kripanshukumar/40hz_brain_wave/Images/IMG_20211009_141126.jpg

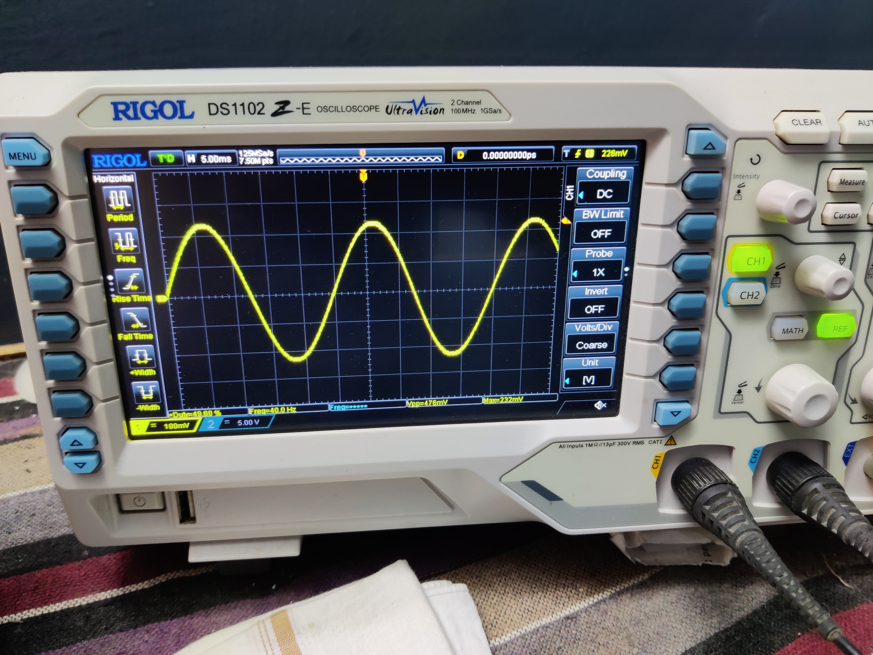
Images/IMG_20211009_141126.jpg
