kripanshukumar/40hz_brain_wave/Images/16253927686848596920687307934046.jpg

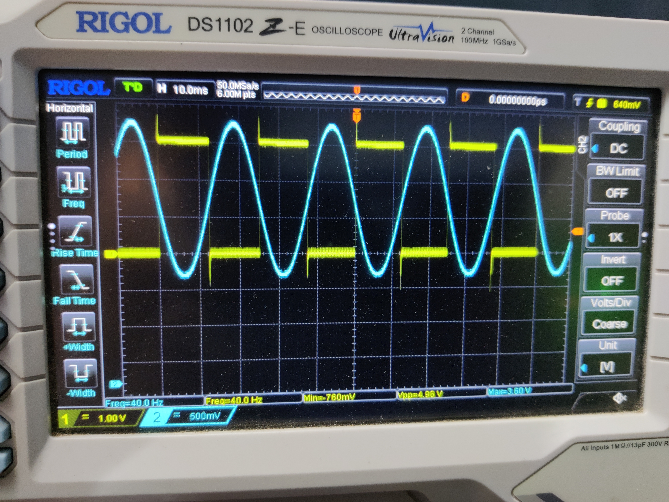
Images/16253927686848596920687307934046.jpg
