kripanshukumar/40hz_brain_wave/Images/IMG_20211008_235200.jpg

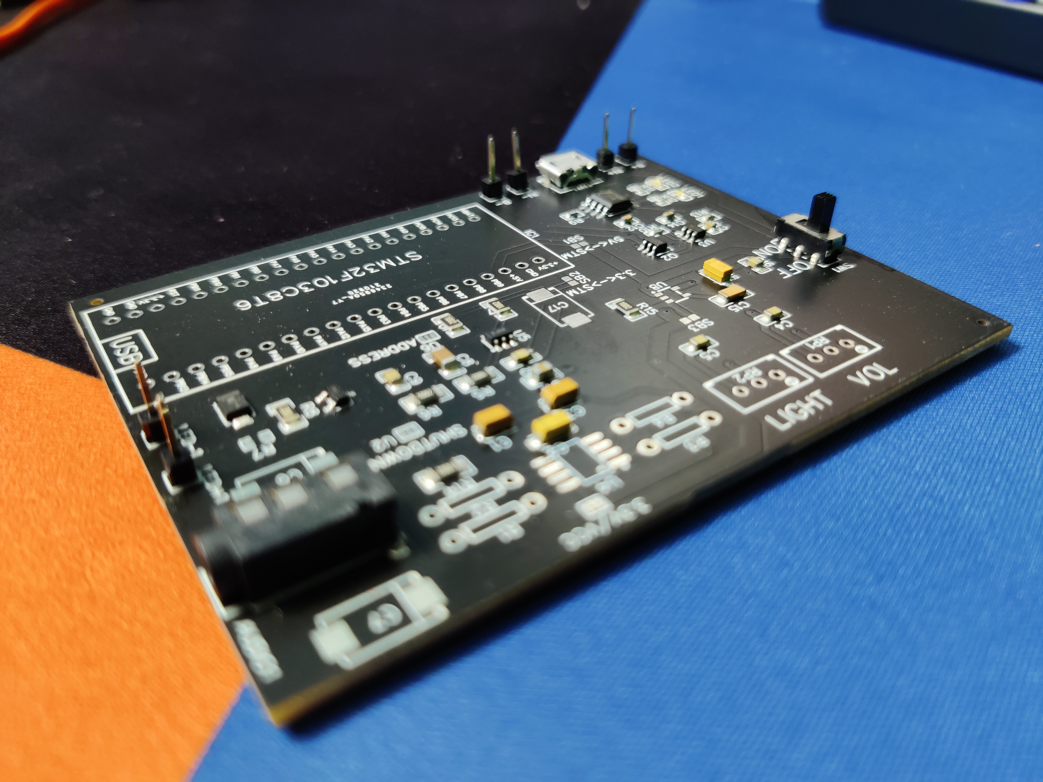
Images/IMG_20211008_235200.jpg
