kripanshukumar/40hz_brain_wave/Images/IMG_20211009_141535__01.jpg

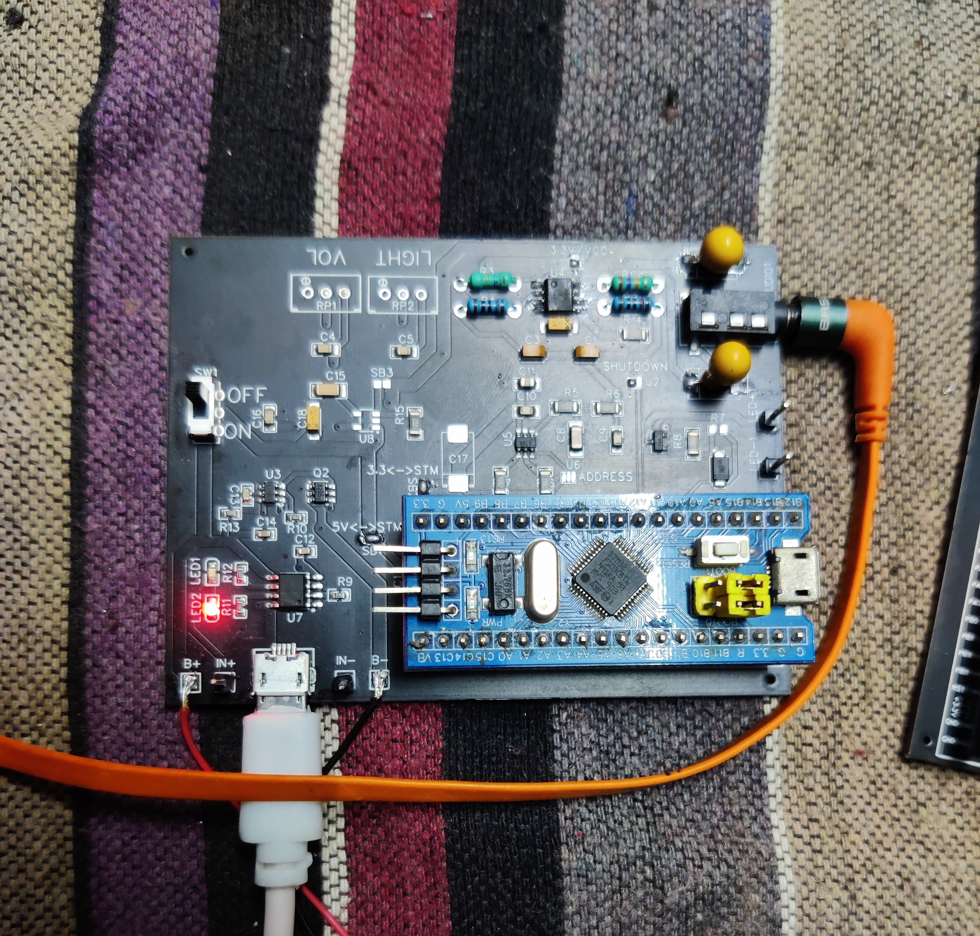
Images/IMG_20211009_141535__01.jpg
