kripanshukumar/40hz_brain_wave/Images/Screenshot 2020-12-07 003954.png

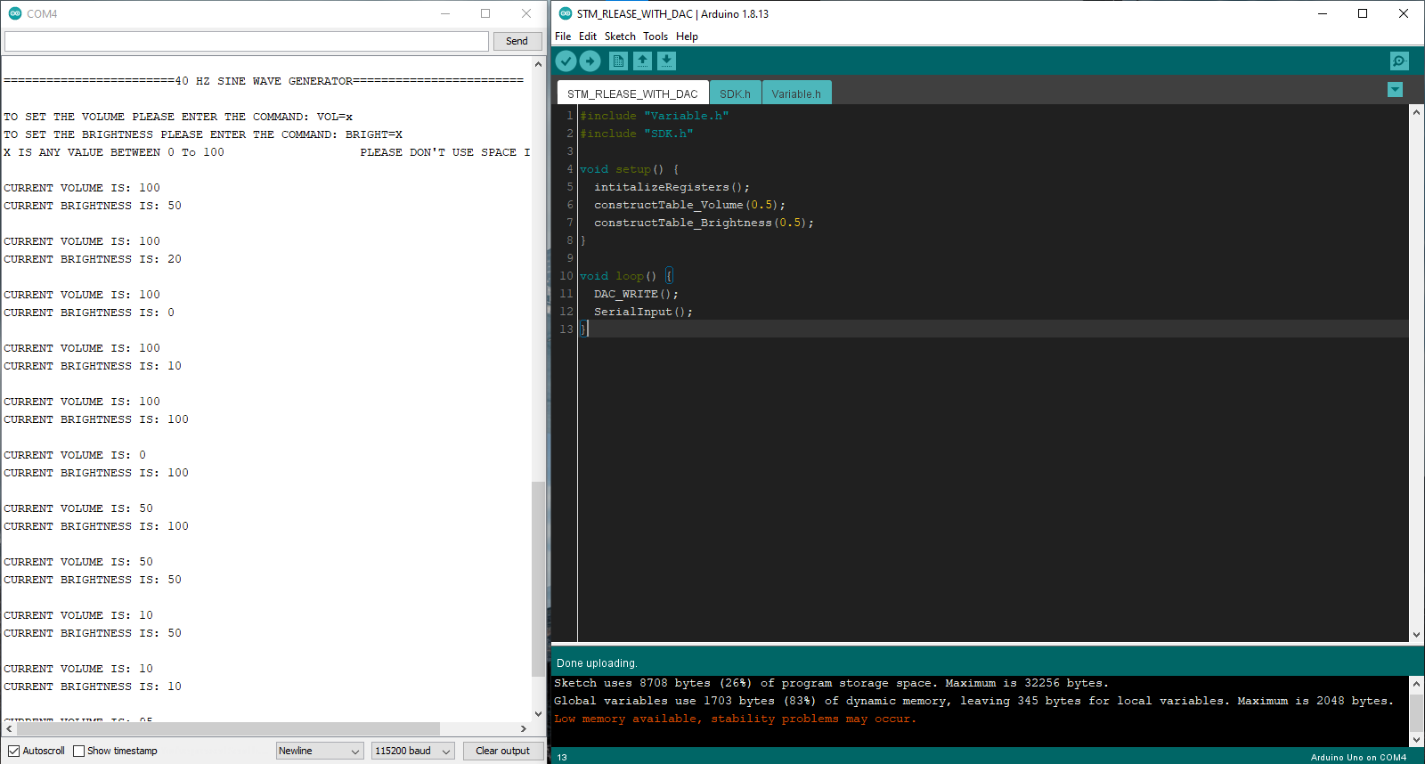
Images/Screenshot 2020-12-07 003954.png
