kripanshukumar/40hz_brain_wave/Images/Screenshot 2021-11-16 134916.png

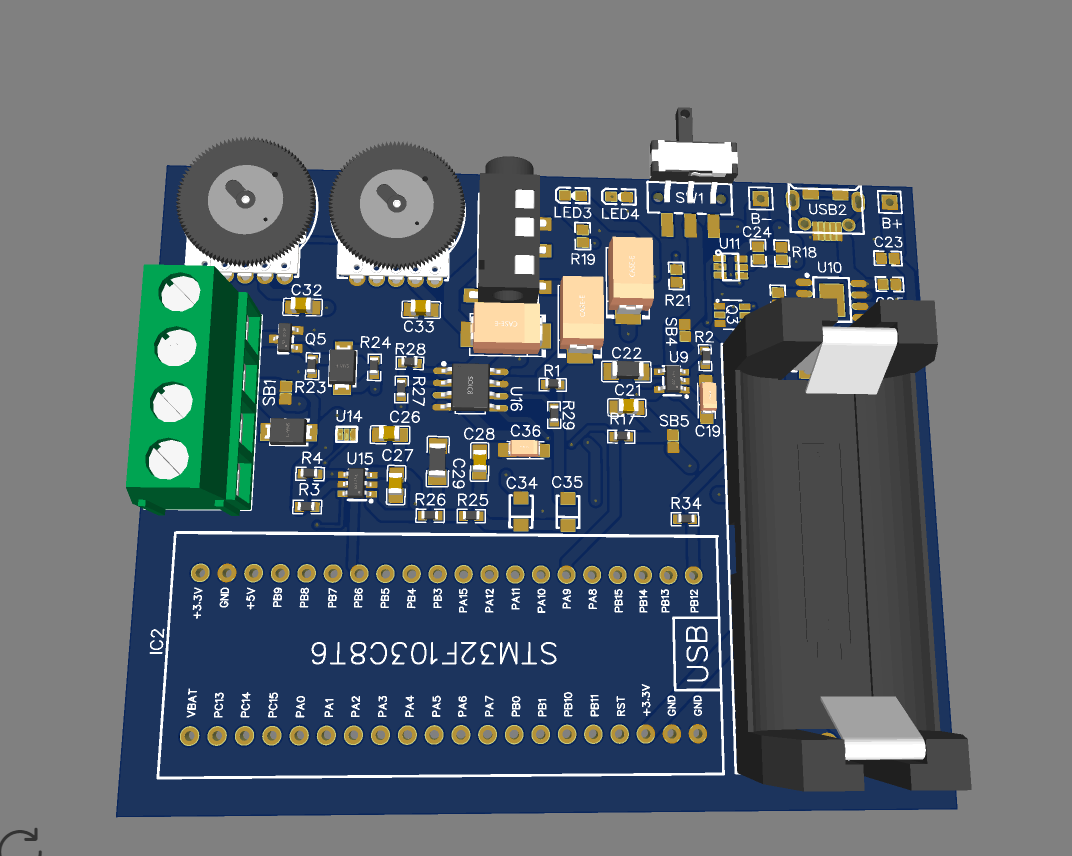
Images/Screenshot 2021-11-16 134916.png
