kripanshukumar/40hz_brain_wave/Images/Screenshot 2021-11-16 135256.png

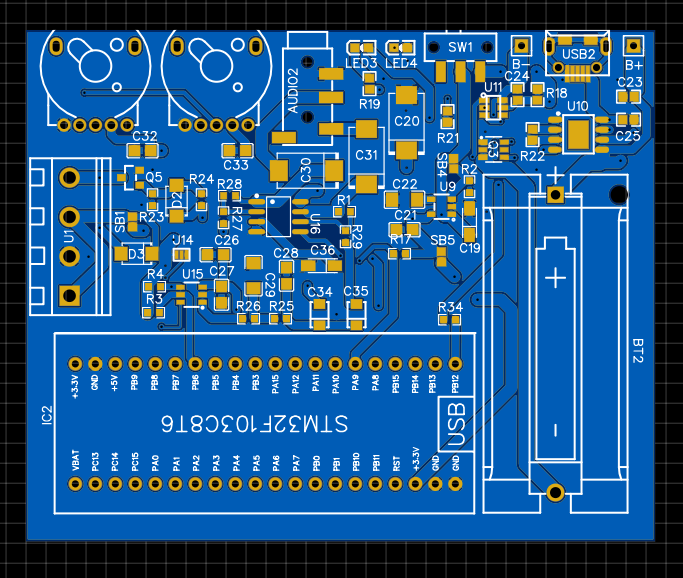
Images/Screenshot 2021-11-16 135256.png
