kripanshukumar/40hz_brain_wave/Images/Screenshot 2021-11-17 122927.png

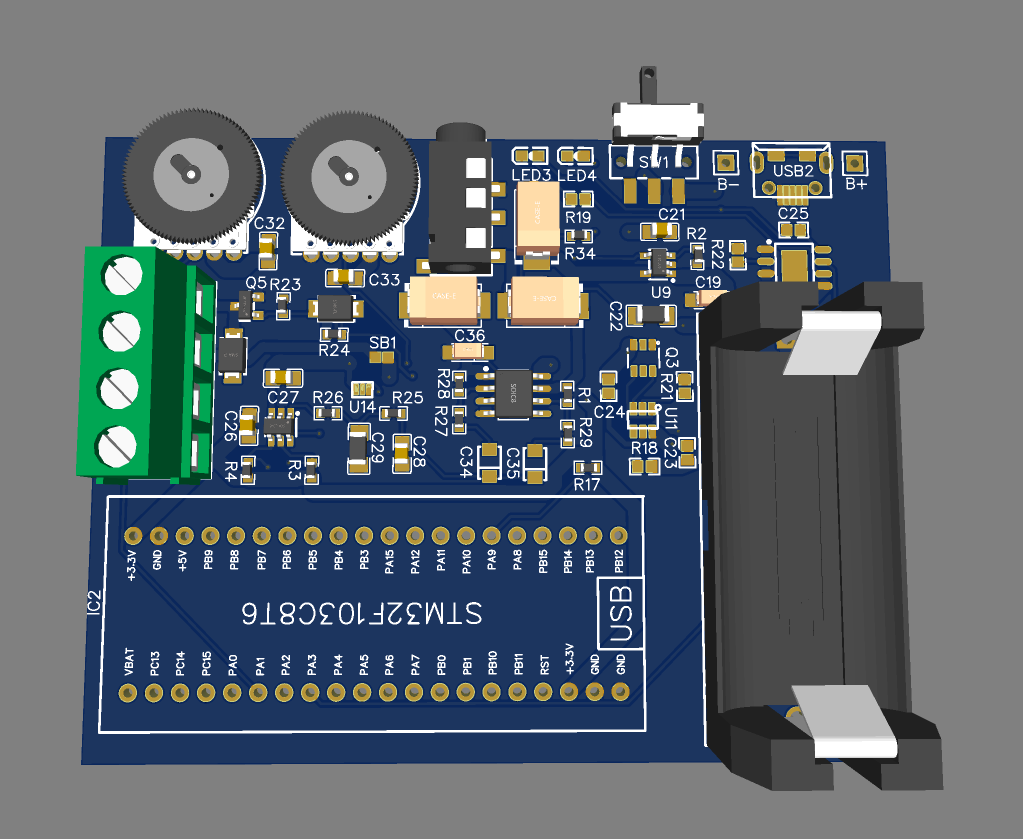
Images/Screenshot 2021-11-17 122927.png
