kripanshukumar/40hz_brain_wave/I2S_WITH_LED_SYNC/Schematic/I2S with ESP32_bb.pdf

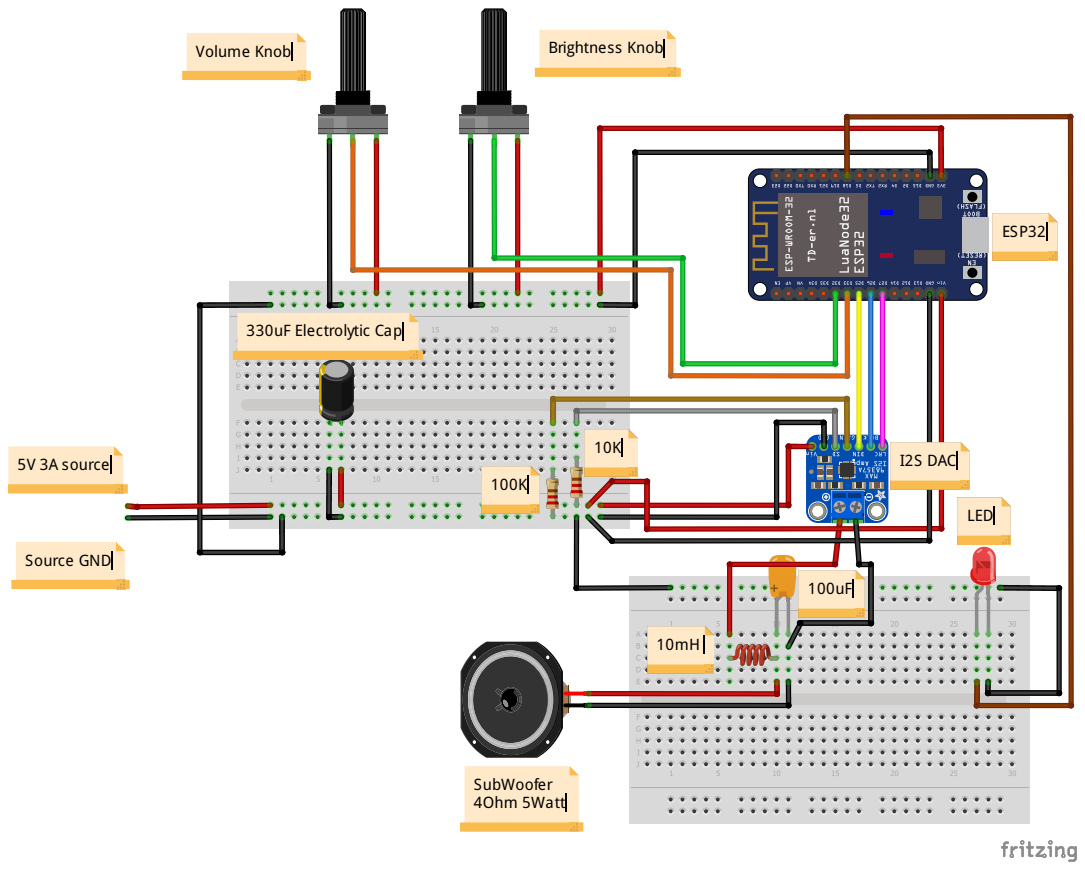
[picture p17: page 1]
5V 3A source; Source GND; 330uF Electrolytic Cap; I2S DAC; ESP32; Volume Knob; Brightness Knob; SubWoofer 4Ohm 5Watt; LED
